tenevoi82/moto-tag-collar-holder/GRID_README.md

# Держатель с защитной решёткой

**Решётка для исправленного корпуса:** см. [отдельную версию V2](v2/README.md). Эта инструкция ниже относится к V1; корпус и накладку разных версий не смешивать.

**Обновление 20.10.2026:** выявлена проблема глубины посадки в исходном корпусе. Решётка не задаёт заднюю опору метки, а её зазор 2,5 мм относится к условной расчётной позиции. См. [аудит корпуса и накладки](validation/MODEL_AUDIT_RU.md). Настройки SCAD теперь описаны по-русски, имена — транслитом: [справочник](PARAMETRY_RU.md).

Дополнительный вариант для той же Moto Tag Ø31,9 × 8 мм и ошейника 21,5 × 3,85 мм. Проверенная на тесте полость метки и проходы ремня сохранены. Основной корпус прежний; добавлена отдельная накладка из TPU 95A.

## Как удерживается метка

Решётка перекрывает наружную сторону метки. Её юбка охватывает оправу с зазором 0,35 мм на сторону и перекрытием 4,5 мм. У накладки два собственных замкнутых ушка: один и тот же ремень проходит через **все четыре ушка** — два корпуса и два накладки. Таким образом, накладка удерживается ремнём; отдельной защёлки, клея или винтов нет.

Ячейки 4,4 мм, перемычки 2,6 мм, толщина решётки 2,4 мм. Даже диагональ ячейки (6,23 мм) меньше толщины метки (8 мм) в недеформированном состоянии. Номинальный зазор от передней поверхности метки до решётки — 2,5 мм. Наружный диаметр накладки 41,4 мм, общий габарит с креплениями около 45,4 × 41,4 × 23,12 мм. Последняя высота включает часть ушек под ремнём.

Это дополнительное механическое удержание, но не гарантия от потери при любых нагрузках: TPU может растягиваться, рваться и расслаиваться. Новая накладка ещё не прошла физическую примерку и испытания на рывок.

## Файлы

| Файл | Что печатать |
|---|---|
| `moto_tag_collar_holder_grid_cap_TPU95A_A1mini.3mf` | Только накладка, если исходный корпус уже напечатан |
| `moto_tag_collar_holder_grid_TPU95A_A1mini.3mf` | Полный комплект: исходный корпус и новая накладка на одном столе |
| `moto_tag_collar_holder_grid_cap.stl` | Только накладка, уже ориентирована для печати |
| `moto_tag_collar_holder_grid.stl` | Две детали, уже ориентированы и разнесены для печати |
| `moto_tag_collar_holder_grid.scad` | Параметрический исходник; `vid_modeli`: `stol`, `nakladka`, `nakladka_v_sborke`, `sborka` |
| `grid_preview.png` | Виды экспортированных STL, сборки и разнесённых деталей |
| `validation/grid/geometry_report.json` | Проверки геометрии и их ограничения |

## Печать и сборка

Открывать 3MF **как проект**, масштаб 100%. Профиль: A1 mini, сопло 0,4 мм, TPU 95A с внешней катушки, слой 0,20 мм, 5 стенок, 40% gyroid, 230 °C сопло / 35 °C PEI, поток 2 мм³/с. Поддержки `tree(auto)` / `tree_slim`, только от стола, Z-зазор 0,30 мм, XY-зазор 0,40 мм, кайма 8 мм. Температуры оставлены из предыдущего проекта; диапазон своей катушки имеет приоритет.

Накладка печатается решёткой на столе. Поддержки нужны верхним частям проходов ремня; их надо полностью удалить. Корпус печатается с прежним наклоном 45°. Не применять автоматическое переориентирование деталей. Поддержки TPU могут потребовать аккуратного разрезания.

Оценка Bambu Studio 02.08.02.61 с подготовкой принтера: только накладка — **1 ч 37 мин, 8,11 г**; полный комплект — **2 ч 58 мин, 13,62 г**. Оба 3MF нарезаны без сообщений об ошибках, проверены контрольные суммы архивов и вложенного G-code. Эти новые задания на принтер не отправлялись.

1. Удалить кайму, поддержки и нити, особенно из всех проходов ремня и ячеек.
2. Вставить метку в исходный корпус кнопкой наружу. Наложить решётку сверху: юбка охватывает кольцо корпуса, все ушки направлены одинаково.
3. Освободить конец ошейника и продеть его последовательно через внешнее ушко накладки, два внутренних ушка корпуса и второе внешнее ушко накладки. Не пропускать ни одно ушко.
4. Проверить, что решётка не нажимает кнопку, метка подаёт звук, ремень изгибается свободно. Слегка нажать на решётку: при обычном касании кнопка не должна срабатывать.
5. Вне собаки потянуть метку наружу, встряхнуть сборку и проверить накладку за разные края. После короткой прогулки осмотреть стойки и слои. До такой проверки не считать удержание подтверждённым.

Для замены батарейки снять ремень с ушек, затем накладку. Перед длительной эксплуатацией нужна примерка именно новой детали; прежний тест подтвердил посадку метки и ремня, но не прочность решётки.

## Дождь и влагозащита

У Moto Tag первого поколения XT2445-1 заявлен **IP67**: лабораторное испытание до 1 м в неподвижной пресной воде до 30 минут. Производитель предупреждает, что защита не постоянна, может снижаться при износе и повреждениях, и не рекомендует намеренное погружение, длительное намокание, напорную и солёную воду. Источник: [официальное руководство Motorola, раздел о воде, стр. 10](https://en-us.support.motorola.com/app/answers/prod_answer_detail/a_id/181324/p/11055).

Практический вывод: дождь соответствует назначению защиты исправной метки с правильно закрытой крышкой; плавание и постоянное нахождение в мокром ошейнике не стоит считать защищёнными условиями. Печатная решётка открыта, имеет дренажные вырезы и не добавляет метке класс IP. Герметичный печатный футляр здесь не заявляется.

После сильного намокания снять держатель с мокрой кожи, вынуть метку и просушить детали, метку вытереть мягкой чистой тканью. Батарейный отсек открывать после высыхания. При закрытии крышки совместить метки в положении Lock согласно руководству. Не заклеивать и не прочищать иглой звуковое отверстие.

## Воспроизведение

```powershell
.\export_grid.ps1
python .\validation\verify_grid.py
python .\prepare_bambu.py moto_tag_collar_holder_grid_cap moto_tag_collar_holder_grid
python .\validation\inspect_bambu.py moto_tag_collar_holder_grid_cap moto_tag_collar_holder_grid
```

Экспорт использует OpenSCAD из `.tools`, проверки — локальные библиотеки Python. Подготовка 3MF выполняется установленным Bambu Studio и не отправляет задание на принтер. Проверки STL и траекторий не заменяют испытаний прочности, удаления поддержек, звука и намокания.
