tenevoi82/moto-tag-collar-holder/preview.png

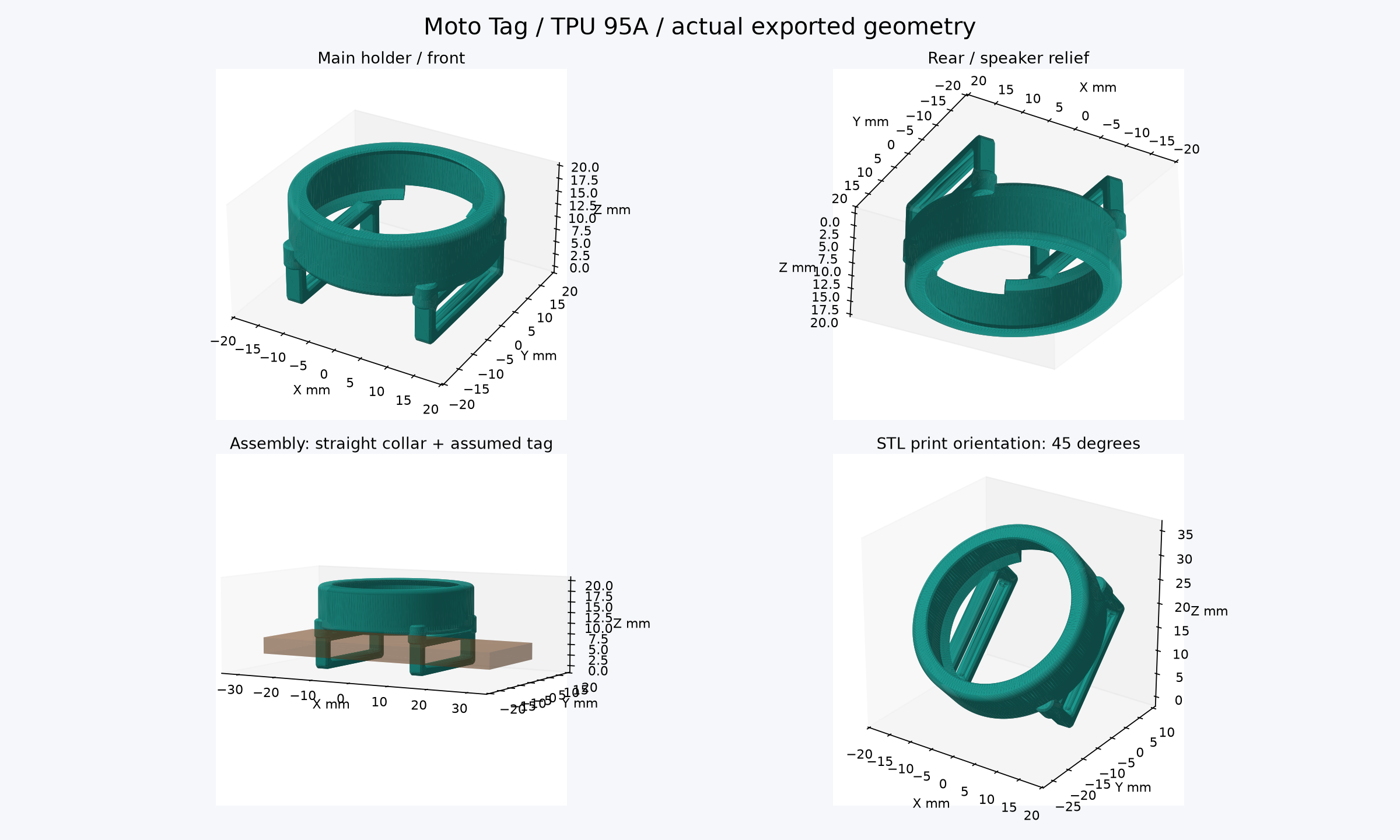
preview.png
