tenevoi82/moto-tag-collar-holder/moto_tag_collar_holder_grid_cap_TPU95A_A1mini.3mf

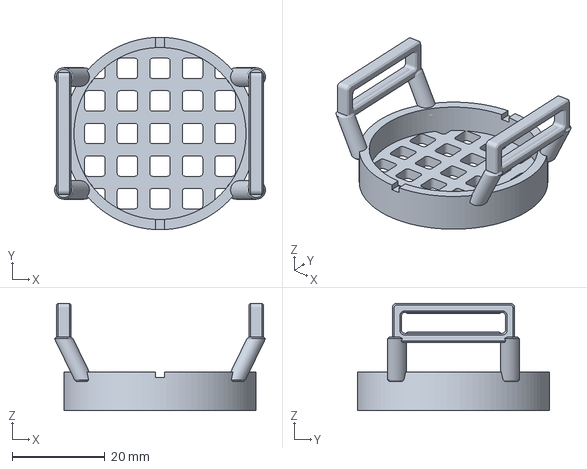
[picture p5: CAD file, 2026-10-19]
moto_tag_collar_holder_grid_cap_TPU95A_A1mini.3mf
45.4 x 41.4 x 23.1 mm
