tenevoi82/moto-tag-collar-holder/v2/moto_tag_collar_holder_grid_cap_v2_TPU95A_A1mini.3mf

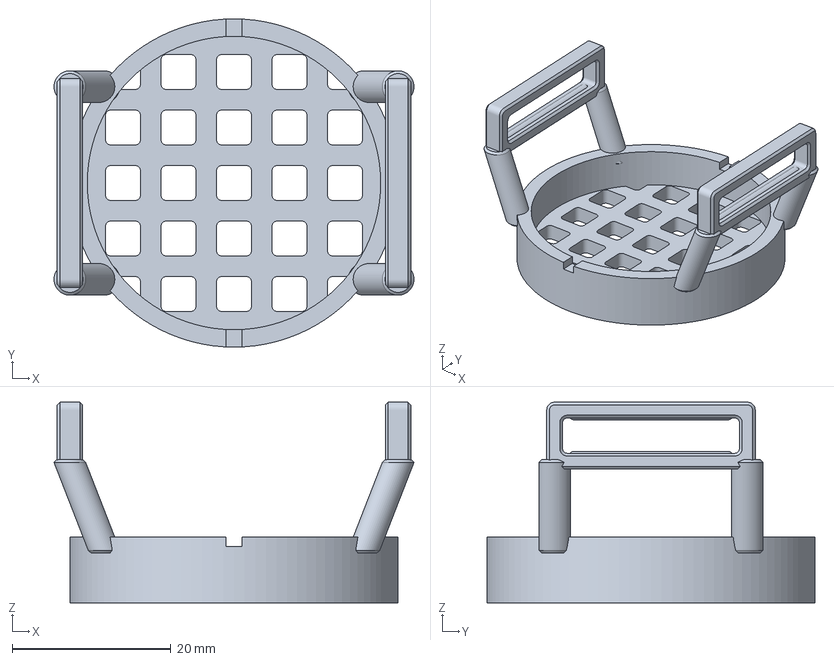
[picture p6: CAD file, 2026-10-20]
v2/moto_tag_collar_holder_grid_cap_v2_TPU95A_A1mini.3mf
45.4 x 41.4 x 25.3 mm
