tenevoi82/moto-tag-collar-holder/v2/validation/tag_reference.stl

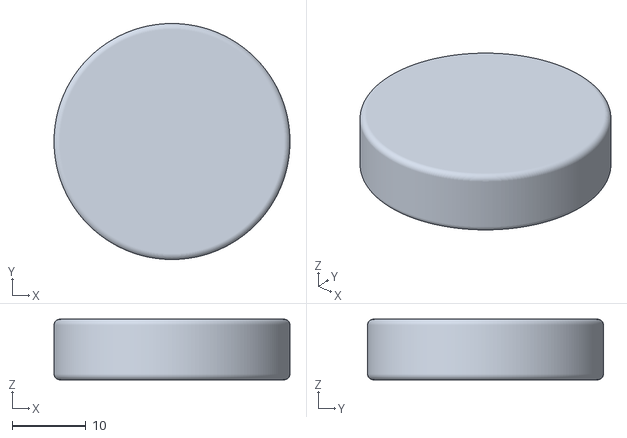
[picture p7: CAD file, 2026-10-20]
v2/validation/tag_reference.stl
31.9 x 31.9 x 8.20
