tenevoi82/moto-tag-collar-holder/validation/holder_installed.stl

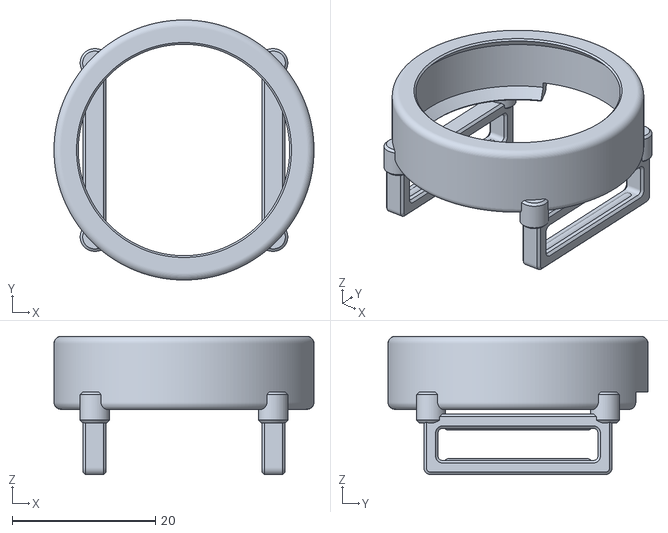
[picture p8: CAD file, 2026-10-19]
validation/holder_installed.stl
36.3 x 36.3 x 19.3
