tenevoi82/moto-tag-collar-holder/moto_tag_collar_holder_grid_TPU95A_A1mini.3mf

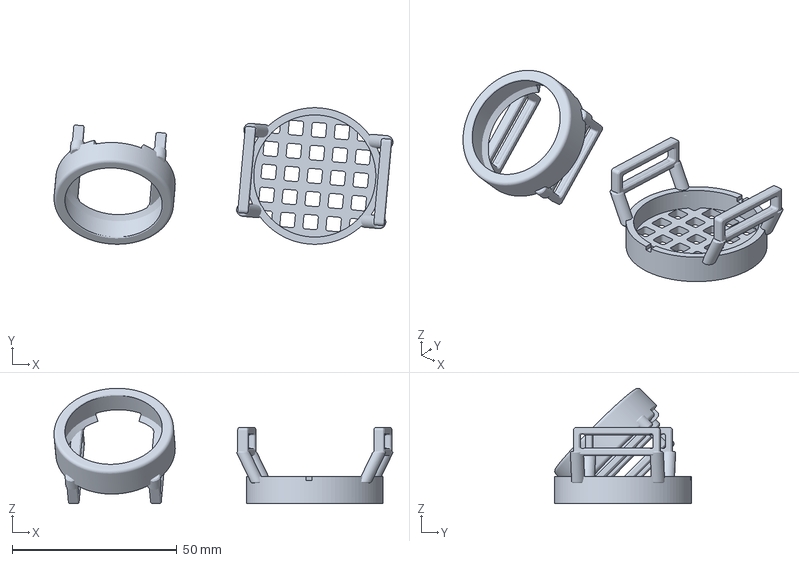
[picture p9: CAD file, 2026-10-19]
moto_tag_collar_holder_grid_TPU95A_A1mini.3mf
102.7 x 41.4 x 35.0 mm
