tenevoi82/moto-tag-collar-holder/v2/moto_tag_collar_holder_grid_v2_TPU95A_A1mini.3mf

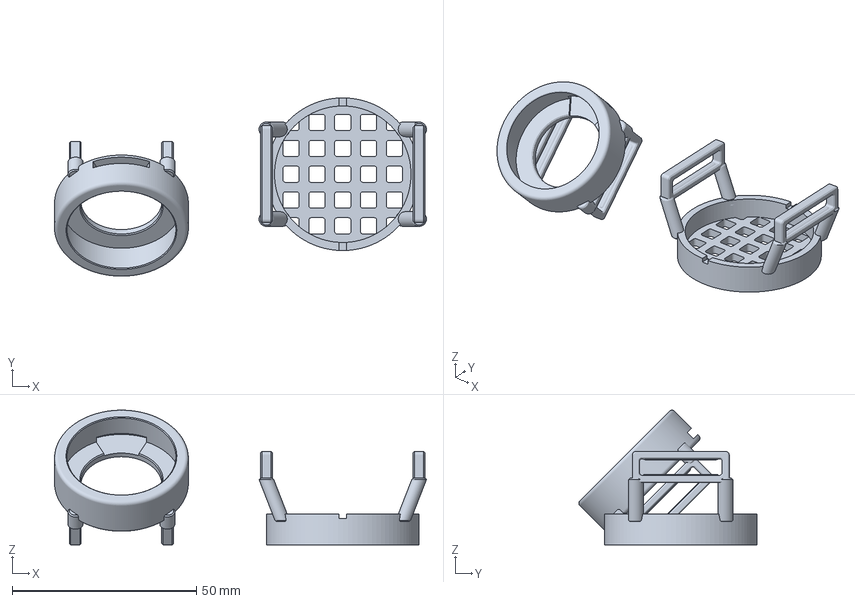
[picture p10: CAD file, 2026-10-20]
v2/moto_tag_collar_holder_grid_v2_TPU95A_A1mini.3mf
100.9 x 48.3 x 36.5 mm
