tenevoi82/moto-tag-collar-holder/validation/tag_reference.stl

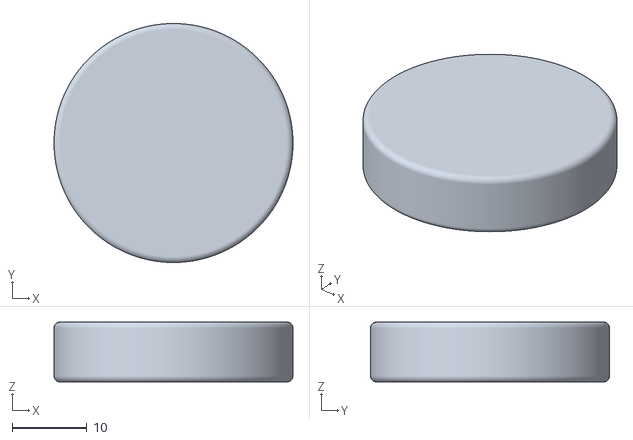
[picture p11: CAD file, 2026-10-19]
validation/tag_reference.stl
31.9 x 31.9 x 8.00
