tenevoi82/moto-tag-collar-holder/moto_tag_collar_holder.stl

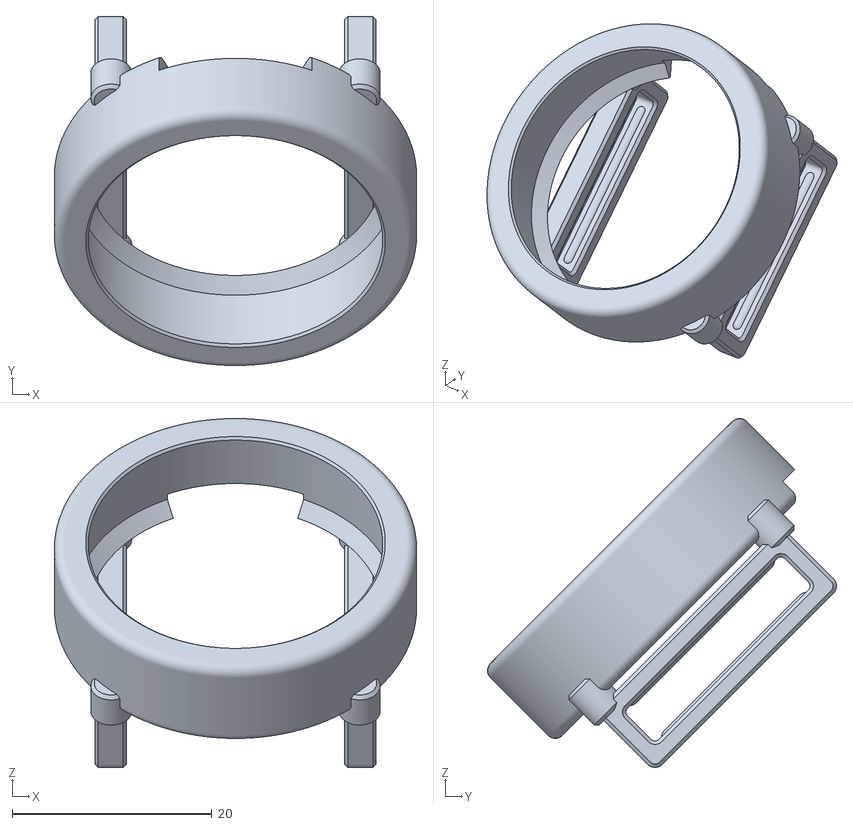
[picture p12: CAD file, 2026-10-19]
moto_tag_collar_holder.stl
36.3 x 35.0 x 35.0
