tenevoi82/moto-tag-collar-holder/v2/validation/holder_installed.stl

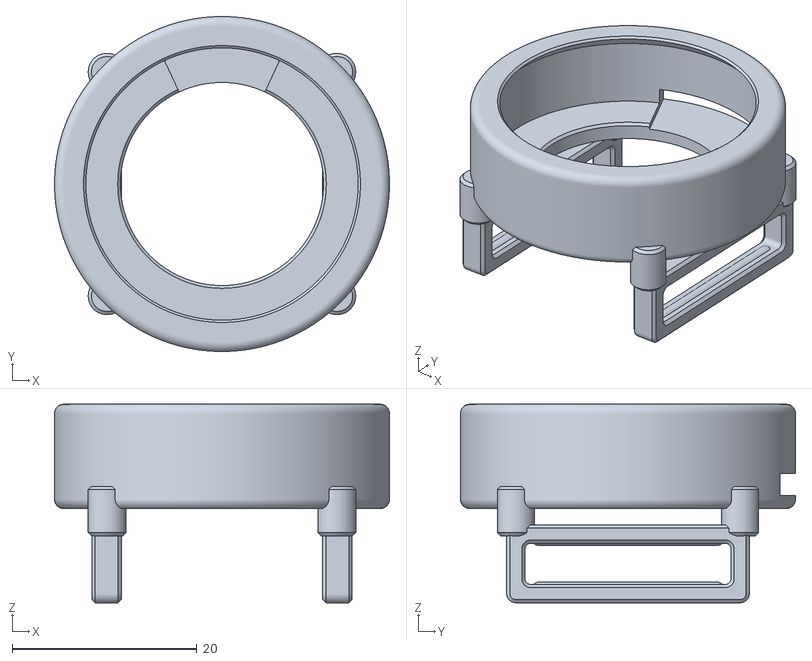
[picture p13: CAD file, 2026-10-20]
v2/validation/holder_installed.stl
36.3 x 36.3 x 21.5
