tenevoi82/moto-tag-collar-holder/fit_test_TPU95A_A1mini.3mf

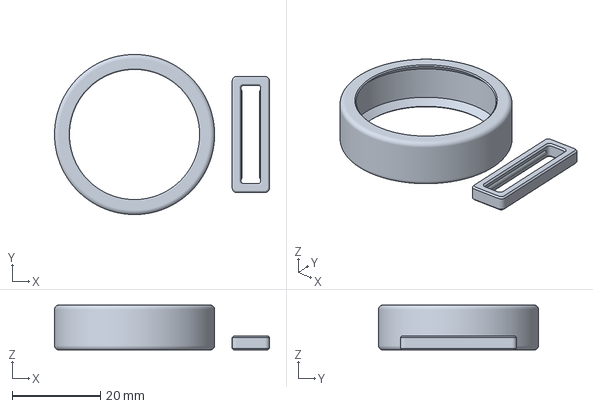
[picture p14: CAD file, 2026-10-19]
fit_test_TPU95A_A1mini.3mf
48.8 x 36.3 x 10.2 mm
