tenevoi82/moto-tag-collar-holder/v2/moto_tag_collar_holder_v2.stl

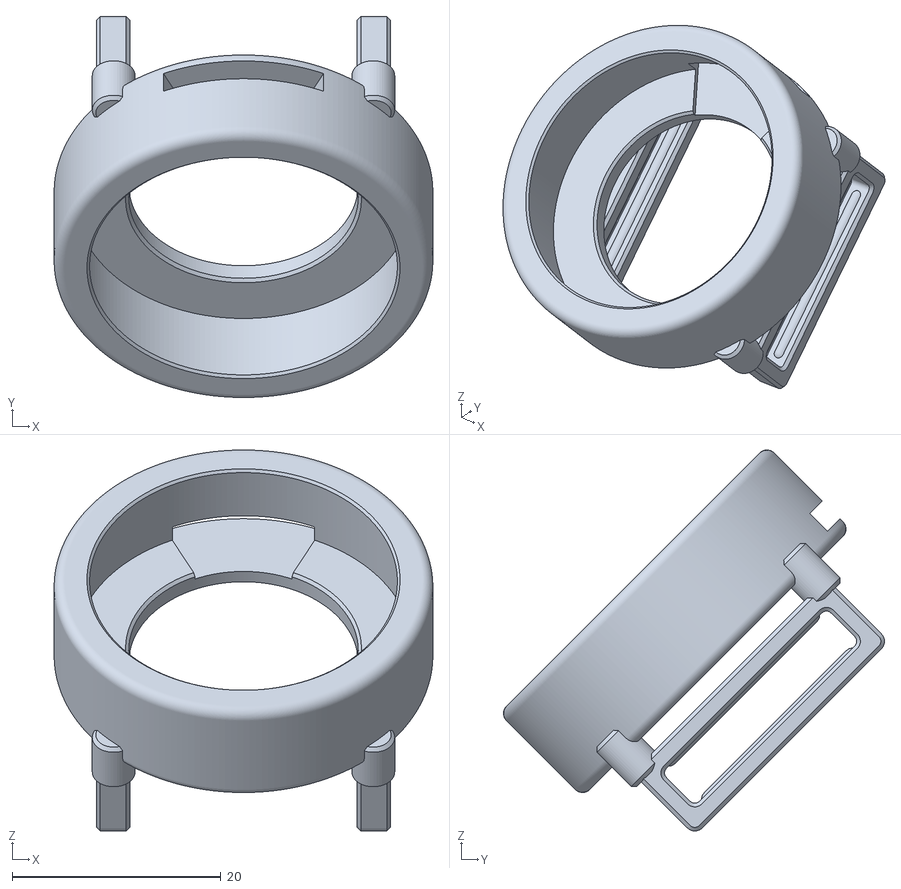
[picture p15: CAD file, 2026-10-20]
v2/moto_tag_collar_holder_v2.stl
36.3 x 36.5 x 36.5
