tenevoi82/moto-tag-collar-holder/moto_tag_collar_holder_grid.stl

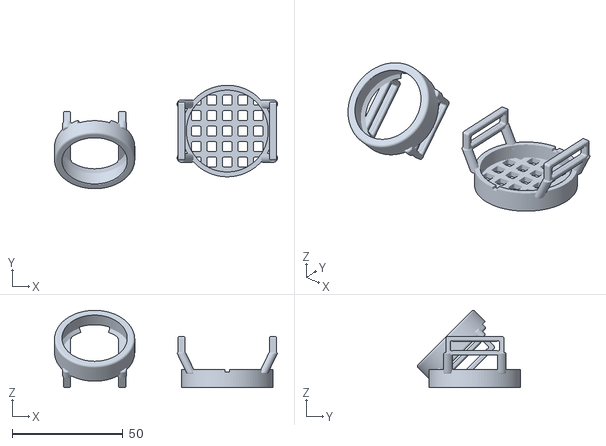
[picture p16: CAD file, 2026-10-19]
moto_tag_collar_holder_grid.stl
100.8 x 46.8 x 35.0
