tenevoi82/moto-tag-collar-holder/validation/tag_reference.scad

// Условный скруглённый диск для проверки. Точный профиль Motorola не измерялся.
use <../moto_tag_collar_holder.scad>
tag_reference();
