tenevoi82/moto-tag-collar-holder/v2/validation/tag_reference.scad

// Условная метка толщиной 8,2 мм; профиль скругления остаётся предположением.
use <../moto_tag_collar_holder_v2.scad>
tag_reference();
