tenevoi82/moto-tag-collar-holder/v2/fit_test_v2.scad

/* Проверочная печать V2 — сам исправленный корпус без накладки.
   Он полностью совпадает с основным корпусом: опора, канал, ушки, стойки,
   наклон 45 градусов. Нужны те же поддержки.
   После успешной примерки этот корпус используется в окончательной сборке.
   Параметры меняются в moto_tag_collar_holder_v2.scad. */
use <moto_tag_collar_holder_v2.scad>
holder_for_print();
