tenevoi82/moto-tag-collar-holder/(list of files, cad)

Other CAD files:
v2/validation/cap_installed.stl
v2/moto_tag_collar_holder_grid_cap_v2.stl
moto_tag_collar_holder_grid_cap.stl
v2/moto_tag_collar_holder_grid_v2.stl
fit_test.stl
v2/moto_tag_collar_holder_v2_TPU95A_A1mini.3mf
moto_tag_collar_holder_TPU95A_A1mini.3mf
v2/moto_tag_collar_holder_grid_v2.scad
v2/moto_tag_collar_holder_v2.scad
validation/grid/cap_installed.stl
