tenevoi82/moto-tag-collar-holder/validation/FIT_TEST_RESULT.md

# Результат физической примерки — 19.10.2026

Проверен напечатанный тест `fit_test_TPU95A_A1mini.3mf`: полное кольцо для метки и отдельный калибр прохода ремня.

На физической примерке подтверждено: метка и ремень вошли без заметного люфта и лишнего усилия. Проверены три фотографии: метка в тестовом кольце с обеих сторон и калибр на реальном кожаном ремне. Личные фотографии в репозиторий не включены.

**Решение на 19.10.2026:** сохранить размеры после примерки теста. Позднейшая примерка основного корпуса обнаружила более глубокую посадку; прежнее решение не является подтверждением корректности основного держателя. См. дополнение ниже.

- Метка: номинально Ø31,9 × 8,0 мм.
- Ремень: номинально 21,5 × 3,85 мм.
- Радиальный зазор метки: 0,20 мм на сторону.
- Осевой припуск в формуле высоты: 0,40 мм; не измеренный свободный ход.
- Дополнительное радиальное сужение кромки: 0,60 мм; не фактический нахлёст на метку.
- Проход ремня: 22,3 × 4,45 мм до рёбер; 3,95 мм между вершинами рёбер.

Использован подготовленный профиль TPU 95A. Точный производитель, марка и партия катушки не сообщены. Фотографии не используются для определения материала или измерения размеров.

Результат подтверждает субъективную посадку тестовых деталей. Он не подтверждает удержание при ударах, изгиб ремня в основном держателе, громкость звука, удаляемость поддержек или долговечность. У тестового кольца задняя кромка непрерывная; у основной модели в ней есть акустический вырез.

На фото видны широкая плоская кайма прилипания к столу (brim) и тонкие нити. Кайма не является частью рабочего крепления; её можно отделить. По одним фотографиям настройки экструзии не менялись.

Основной проект: `moto_tag_collar_holder_TPU95A_A1mini.3mf`, подготовлен ранее, геометрия без изменений.

## Дополнение — 20.10.2026

Основной держатель напечатан. Пользователь сообщил утопление метки примерно 3,5 мм, высоту кольца 10,2 мм, толщину метки 8,2 мм и отсутствие выступания сзади. Эти сведения не отменяют успешную примерку теста, но показывают, что она не проверяла положение метки в основном корпусе. Задний край кольца находится примерно на 9,12 мм выше задней стороны всего держателя; эти плоскости нельзя смешивать при сравнении размеров. Разбор геометрии, зазоров и ограничений — [MODEL_AUDIT_RU.md](MODEL_AUDIT_RU.md).
