tenevoi82/moto-tag-collar-holder/validation/MODEL_AUDIT_RU.md

# Аудит посадки и параметров — 20.10.2026

**Продолжение работы:** по этому аудиту создана отдельная [версия V2 с задней опорой](../v2/README.md). Этот документ и его численные результаты описывают исходную V1.

Проверены исходники корпуса, теста и накладки, опубликованные STL и сетки внутри четырёх проектов 3MF. Проверка выполнена после сообщения об утоплении метки примерно на 3,5 мм. Пользователь сообщил высоту кольца 10,2 мм, толщину метки 8,2 мм и отсутствие выступания сзади держателя. Повторные замеры не требовались.

## Основной вывод

Модель не задаёт надёжно подтверждённую глубину посадки реальной метки. Она удерживает её двумя сужающимися упругими кромками, причём задняя кромка имеет вырез. Отдельной широкой задней опоры, задающей глубину независимо от округлого края метки, нет. Проверка условного диска в заранее выбранной позиции была ошибочно принята за достаточную проверку посадки.

Это недостаток конструкции и её проверки. Он делает смещение при деформации TPU правдоподобным, но имеющихся данных недостаточно, чтобы доказать единственную физическую причину именно 3,5 мм. Жёсткая условная метка при таком смещении пересекается с корпусом: модель без деформации не воспроизводит наблюдение. Реальный профиль метки, состояние напечатанных кромок и упругая деформация в расчёте отсутствуют.

## Найденные ошибки и ограничения

1. **Различаются тест и основной корпус.** В `fit_test.scad` вызывается `ring_only(false)`: задняя кромка непрерывная. В основном корпусе вырезается сектор 50° высотой 2,4 мм, включая участок задней кромки. Успешная примерка теста подтверждает его посадку и проход ремня, но не равнозначна проверке заднего удержания основного корпуса.
2. **Неверная исходная толщина для этой метки.** В опубликованной геометрии использовано 8,0 мм, измерено 8,2 мм. Разница 0,2 мм требует учёта при переработке, но не объясняет сама по себе утопление 3,5 мм. Простое увеличение параметра толщины увеличит высоту кольца, а не создаст задний упор.
3. **Высота метки была задана, а не найдена по устойчивой посадке.** `tag_back` вычисляется из высоты кольца и припусков. Условный диск помещается туда программно, затем проверяется отсутствие пересечений. Это не расчёт сил удержания или положения после вставки. Накладка также рассчитывает зазор до этой условной позиции.
4. **Осевой припуск назван неточно.** Прежнее `tag_axial_clearance = 0.4` входит в формулу высоты кольца. Это не свободный ход реальной метки. Для условного диска Ø31,9 × 8,0 мм со скруглением 0,8 мм расчёт по STL даёт около 0,237 мм суммарного хода до пересечения с корпусом. Параметр переименован в `osevoy_pripusk_metki`, описание исправлено.
5. **Размер удерживающей кромки не равен фактическому нахлёсту.** Прежнее `retention_lip = 0.6` дополнительно сужает отверстие после вычитания условного скругления. Минимальное отверстие — Ø29,5 мм; нахлёст на плоскую часть условной метки — 0,4 мм на сторону. На самом торце фаска уменьшает его до 0,15 мм. Эти величины зависят от принятого профиля метки; это не измерение реального контакта. Параметр теперь называется `radialnoe_suzhenie_bortika`.

## Исправление прежнего объяснения размеров

Задняя плоскость кольца и задняя плоскость всего держателя находятся на разных уровнях. Ранее они ошибочно считались одной плоскостью, из-за чего показания пользователя были объявлены несовместимыми.

Координаты в положении на ошейнике, отсчёт от задней стороны ушек:

| Плоскость | Высота Z, мм |
|---|---:|
| Задняя сторона всего держателя | 0,00 |
| Задний край кольца | 9,12 |
| Расчётная задняя поверхность условной метки 8 мм | 10,22 |
| Расчётная передняя поверхность условной метки 8 мм | 18,22 |
| Передний край кольца | 19,32 |

Поэтому расчётное утопление — **1,10 мм**, а не 3,5 мм. При отсчёте 3,5 мм от переднего края кольца передняя поверхность окажется на Z ≈ 15,82 мм. Если толщина 8,2 мм отложена от той же поверхности, задняя окажется на Z ≈ 7,62 мм: на 1,50 мм ниже заднего края кольца, но всё ещё внутри общего габарита держателя. Поэтому фраза «сзади не выступает» сама по себе не противоречит такому утоплению.

Это только сопоставление уровней. Оно не доказывает, что жёсткая метка свободно помещается в таком положении: расчёт условного профиля показывает пересечения. Также большая синяя поверхность на фото может не совпадать с крайней точкой, по которой измерялась полная толщина.

## Что означают зазоры

| Величина | Значение и смысл |
|---|---|
| Боковой зазор | 0,20 мм на сторону между максимальным диаметром условной метки и цилиндрической частью полости |
| Утопление спереди | 1,10 мм в исходной расчётной позиции; пользователь сообщил примерно 3,5 мм |
| Запас под меткой до прямого ремня | Не менее 3,77 мм в расчётной позиции; заложен для изгиба ошейника и прохода звука |
| Запас после принятого изгиба ремня | 1,20 мм при расчётном радиусе 40 мм; реальная форма кожи не моделируется |
| Зазор накладки сбоку | 0,35 мм между юбкой накладки и наружной стороной кольца |
| Зазор до решётки | 2,50 мм до условной передней поверхности, не измеренный зазор реальной кнопки |

Если синяя поверхность действительно утоплена на 3,5 мм, а накладка встаёт в расчётное положение, расстояние от неё до решётки получается около 4,9 мм. Это не означает такой же зазор до выступающей кнопки и не проверяет прогиб решётки. Решётка ограничивает выход наружу, но не исправляет положение метки внутри корпуса.

## Проверка файлов и перевод

- Установленный OpenSCAD 2021.01 отвергает кириллицу в именах переменных; проверено отдельным минимальным примером с ASCII-контролем.
- 42 пользовательских параметра получили имена транслитом, описания и группы — по-русски. Встроенные команды, служебная группа `[Hidden]`, внутренние функции и вычисляемые величины сохранены.
- Обновлены обращения в исходниках, скрипте экспорта накладки и Python-проверках. Справочник: [PARAMETRY_RU.md](../PARAMETRY_RU.md).
- Все семь вариантов прошли компиляцию без предупреждений: корпус, тест, условная метка, комплект для печати, накладка для печати, накладка в положении сборки, сборка. CSG до и после перевода совпадает побайтно. Проверены также переопределения новых параметров через `-D`.
- Во всех четырёх 3MF преобразования сохраняют масштаб 100%. Встроенные сетки согласуются со STL: одинаковое число треугольников, отклонение каждой вершины до ближайшей вершины другой сетки после совмещения переносом меньше 0,000005 мм, относительная разница объёмов меньше 0,00000005. Это исключает изменение масштаба или размеров встроенной сетки при подготовке этих проектов; физическую точность принтера проверка не определяет.
- Численные результаты и проверка 53 обращений к переименованным параметрам записаны в [model_audit.json](model_audit.json). Скрипт: `python validation/audit_model.py`.
- Перевод сохраняет опубликованную геометрию. Изменение механики заднего упора и новый экспорт STL/3MF в этот аудит не входят; прежние файлы нельзя считать исправленной конструкцией.

## Направление исправления конструкции

Следующая версия должна задавать глубину отдельной задней опорой под подходящую поверхность метки, учитывать толщину 8,2 мм и сохранять возможность установки и извлечения. Звуковой канал следует отделить от несущих участков опоры. Тест должен воспроизводить ту же опору, вырезы и ориентацию печати, что основной корпус. Уменьшать высоту кольца на 3,5 мм вслепую нельзя: это не исправляет способ удержания и меняет положение передней кромки.

Аудит геометрии не определяет прочность TPU, усилие извлечения или ресурс. Эти свойства ранее не были подтверждены успешной вставкой в тестовое кольцо.
