tenevoi82/moto-tag-collar-holder/validation/BAMBU_CHECK.md

# Проверка Bambu Studio — 19.10.2026

Версия: **02.08.02.61**, Windows. Проверка выполнена после восстановления повреждённых настроек приложения.

| Проверка | Тест посадки | Основной держатель |
|---|---|---|
| Возврат Bambu CLI | `0`, `Success.` | `0`, `Success.` |
| Слой модели | 0,20 мм | 0,20 мм |
| Стенки / заполнение | 5 / 40% gyroid | 5 / 40% gyroid |
| Поддержки | Выключены | tree(auto), tree_slim, от стола |
| Число слоёв G-code | 51 | 306, включая отдельные уровни поддержек |
| Время с подготовкой | 42 мин 8 с | 1 ч 28 мин 38 с |
| Время без подготовки | 34 мин 19 с | 1 ч 20 мин 49 с |
| Расход по расчёту слайсера | 3,81 г | 5,74 г, с поддержками |
| Новые островки без предшествующего слоя/опоры, по растровой проверке | 0 | 0 |

Оба проекта содержат сетку модели, полные настройки A1 mini / 0,4 мм, профиль TPU, G-code и изображения Bambu Studio. Ориентация основного STL 45° сохранена; тест лежит плашмя. Сопло 230 °C, текстурированная PEI 35 °C, предел объёмного потока 2 мм³/с, внешняя катушка. Профили раскрыты из ресурсов установленной версии с наследованием и штатными шаблонами G-code, а не собраны из профиля PLA.

Основной проект дополнительно открыт в интерфейсе Bambu Studio как проект: выбран A1 mini, загружен TPU 95A Moto Tag, выполнена повторная нарезка, кнопка «Распечатать стол» стала доступна. На принтер задание не отправлялось.

Позднее пользователь отправил тест на печать и 19.10.2026 подтвердил успешную примерку метки и ремня, приложив три фотографии. Сводка выше относится к расчётам слайсера; измеренных времени и массы печати нет. Основной держатель пока физически не проверен. См. `FIT_TEST_RESULT.md`.

## Проверка поддержек

`inspect_bambu.py` читает фактический G-code, учитывает линейные перемещения и дуги G2/G3 и растеризует полосы экструзии с шагом 0,10 мм. Для каждого нового связного участка модели проверяется наличие предыдущего модельного слоя либо поддержки снизу. Найдены поддержанные новые участки на Z=3,20 мм (начало нижней дуги) и два малых участка на Z=4,40 мм. Полностью новых неподкреплённых островков не обнаружено. Есть опоры и под верхними нависающими частями оправы. В тесте присутствуют brim, стенки и поверхности, без траекторий Support.

Проверка использует XY-допуск 0,50 мм и историю поддержек до 0,75 мм по высоте; она выявляет целые островки, но не доказывает приемлемое качество каждой локальной консоли. Опоры из TPU могут крепко сцепиться с деталью. Их удаление, доступность проходов после очистки, посадка, усилие удержания, звук и усталостная прочность остаются предметом физической проверки.

Схемы фактических траекторий:

- `bambu/fit_test/toolpaths.png`
- `bambu/moto_tag_collar_holder/toolpaths.png`

Оранжевый — модель; синий — поддержки и brim. Численные отчёты находятся рядом в `toolpath_audit.json`; результат слайсера — в `result.json`.

## Примечания к метаданным

Строка `warning_message` в результатах нарезки пуста. Внутри 3MF также сохранены штатные уведомления `not_support_traditional_timelapse`: они касаются обычного таймлапса, а не незамкнутой геометрии или неподдержанных островков. Для примерки таймлапс не требуется.

Расход и время — оценка слайсера, не измерение физической печати. Настройки 230/35 °C являются исходной точкой для обычного TPU 95A; диапазон конкретной катушки имеет приоритет. Сначала напечатайте тест, проверьте ремень и метку, затем основной держатель.
