tenevoi82/moto-tag-collar-holder/validation/grid/VALIDATION.md

# Проверка варианта с решёткой — 19.10.2026

OpenSCAD 2021.01 выполнил CGAL-экспорт: накладка — Simple yes, Volumes 2 (включая внешнюю область); стол с двумя деталями — Simple yes, Volumes 3.

`verify_grid.py` подтвердил:

- Накладка — одно замкнутое связное тело, 14 784 треугольника; полный стол — два тела, 34 554 треугольника. Согласованное направление граней, положительный объём, Manifold NoError.
- Нулевые объёмы пересечений накладки с исходным корпусом, моделью метки, прямым ошейником, свободной зоной кнопки высотой 2 мм и задним воздушным коридором.
- Зазор до номинальной передней поверхности метки 2,5 мм. Прямой путь установки проверен с шагом 1 мм на протяжении 30 мм; пересечений не найдено. Это дискретная проверка, не непрерывная симуляция.
- Сквозными цилиндрическими пробами проверена 21 полная ячейка решётки, отдельно подтверждено наличие материала в перемычке. Ячейка 4,4 мм, диагональ 6,223 мм против толщины метки 8 мм; сравнение относится к недеформированной геометрии.

Bambu Studio 02.08.02.61 успешно нарезал оба проекта. CRC архивов и MD5 вложенного G-code совпали; в проектах подтверждены A1 mini, TPU, слой 0,2 мм, 5 стенок, заполнение 40%, сопло 230 °C, поток 2 мм³/с, включённые поддержки. Предупреждений слайсера нет.

Траектории накладки проверены растровым анализом с шагом 0,1 мм: две новые области модели на Z=21 мм имеют поддержки; полностью новых неподкреплённых компонентов не обнаружено. Подробности и виды траекторий находятся в `validation/bambu/moto_tag_collar_holder_grid_cap/`. Анализ обнаруживает отдельные островки, но не доказывает качество каждого нависания, лёгкость снятия поддержек или сцепление со столом.

Та же проверка полного комплекта прошла без кандидатов на неподкреплённые компоненты. Пять новых областей имеют поддержки: Z=3,2 мм, два участка Z=4,4 мм и два участка Z=21 мм. Отчёт и виды — в `validation/bambu/moto_tag_collar_holder_grid/`.

Оценки времени с подготовкой / массы: накладка 5826 с / 8,11 г; комплект 10652 с / 13,62 г. Проверены изображения реальных STL и G-code накладки.

Физически проверена пользователем только предыдущая тестовая посадка метки и ремня. Сборка новой накладки, нажатие кнопки при прогибе, звук, прочность, усталость, рывки и намокание ещё не испытаны. Печатные детали не получают класс IP; защита от воды относится к самой исправной метке согласно Motorola. Новая печать не запускалась.
