tenevoi82/moto-tag-collar-holder/v2/validation/bambu/moto_tag_collar_holder_v2/toolpaths.png

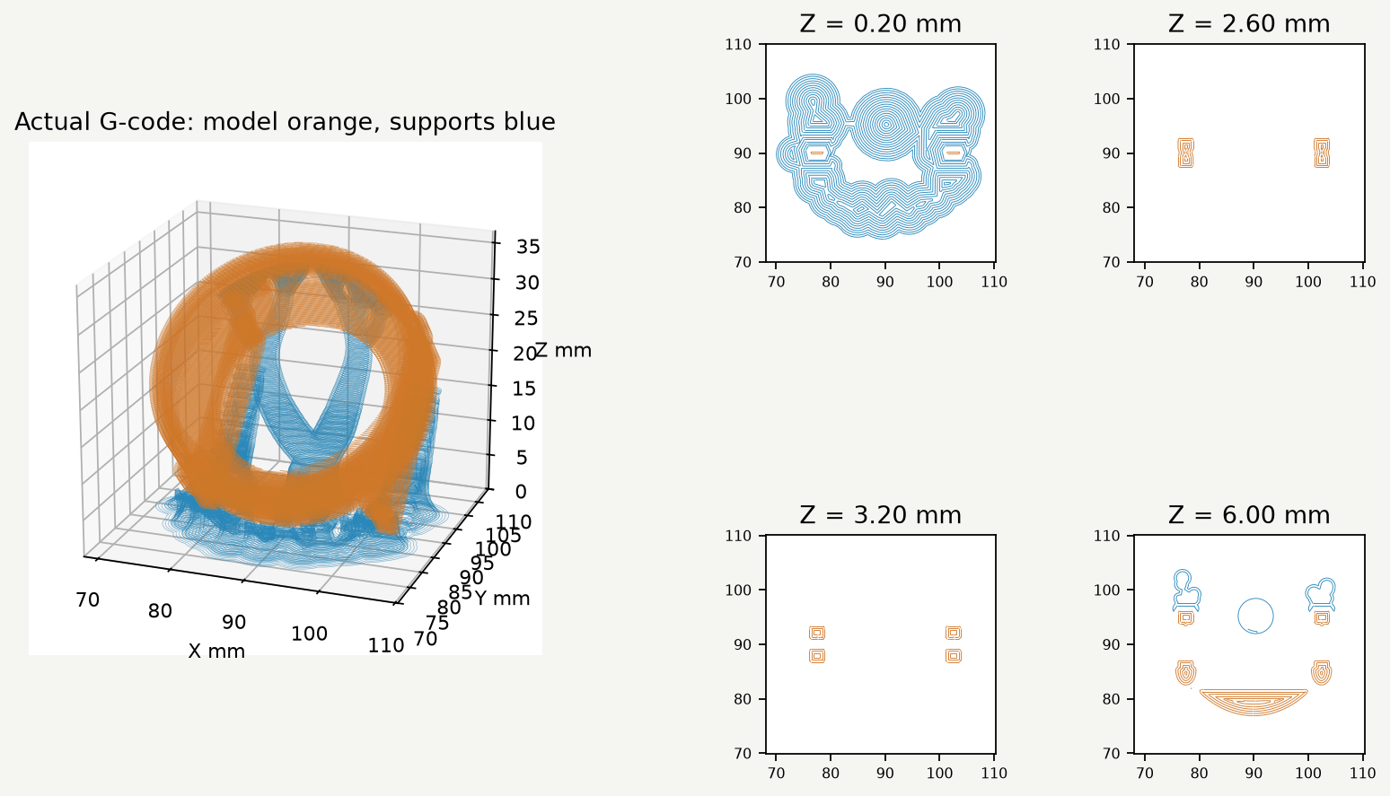
v2/validation/bambu/moto_tag_collar_holder_v2/toolpaths.png
