tenevoi82/moto-tag-collar-holder/validation/sections.png

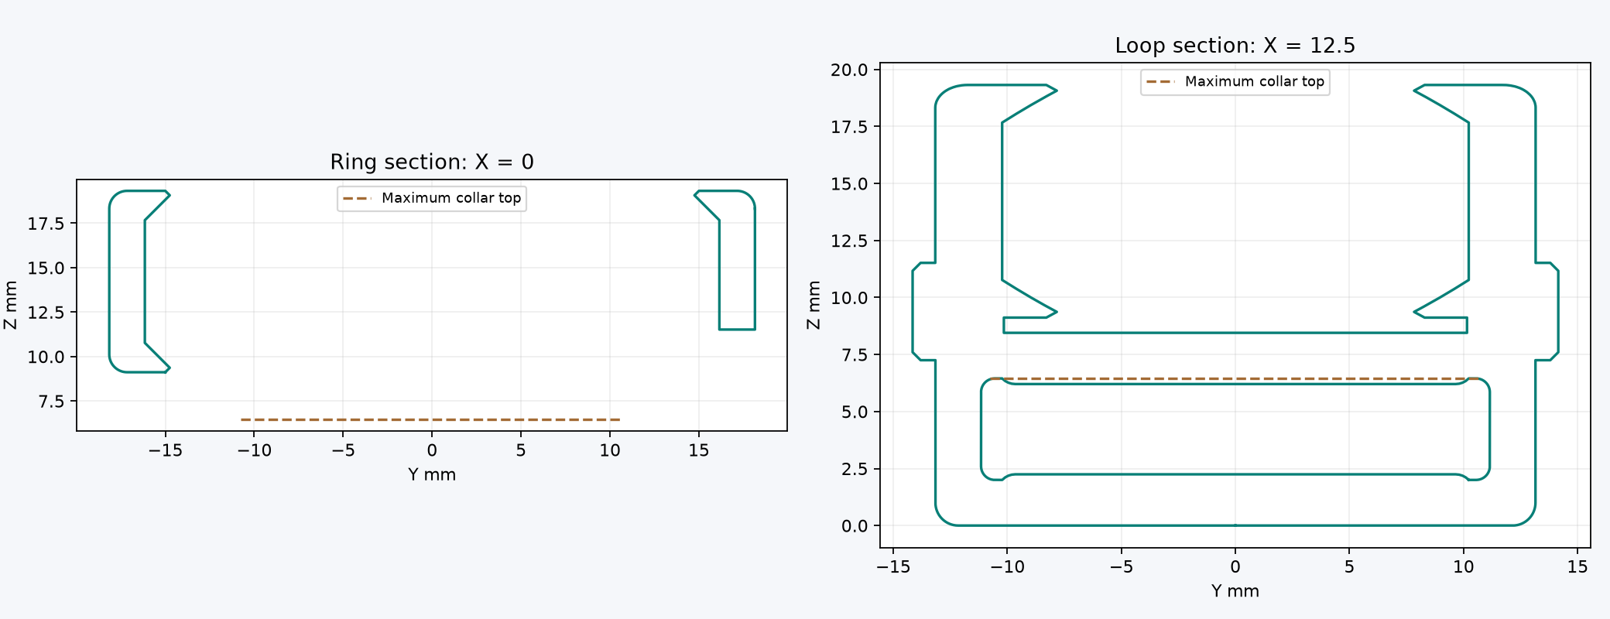
validation/sections.png
