tenevoi82/moto-tag-collar-holder/(commit log)

2026-10-19 Publish Moto Tag collar holder and protective grille
    [cap_installed.stl, fit_test.scad, fit_test.stl, fit_test_TPU95A_A1mini.3mf, holder_installed.stl, machine.json, moto_tag_collar_holder.scad, moto_tag_collar_holder.stl]
2026-10-20 Add V2 rear support and Russian OpenSCAD parameters
    [cap_installed.stl, fit_test.scad, fit_test_v2.scad, holder_installed.stl, machine.json, moto_tag_collar_holder.scad, moto_tag_collar_holder_grid.scad, moto_tag_collar_holder_grid_cap_v2.stl]
